snafu-ca/serial-gauge/docs/parts included.png

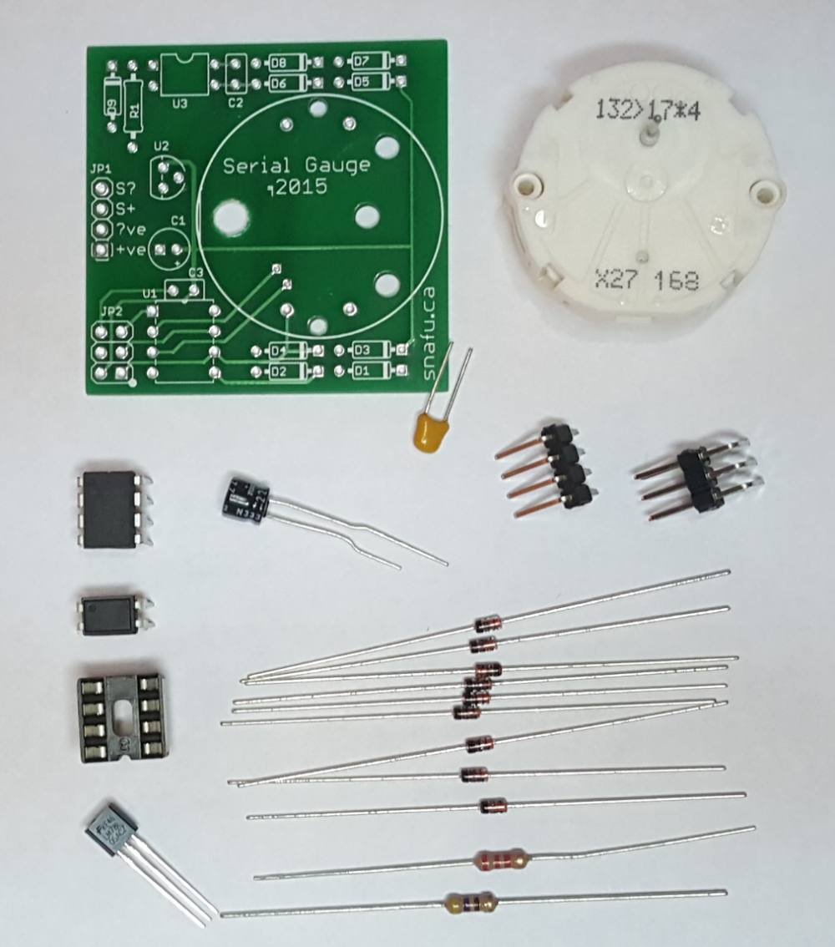
docs/parts included.png
