snafu-ca/serial-gauge/docs/Drive From Pi.png

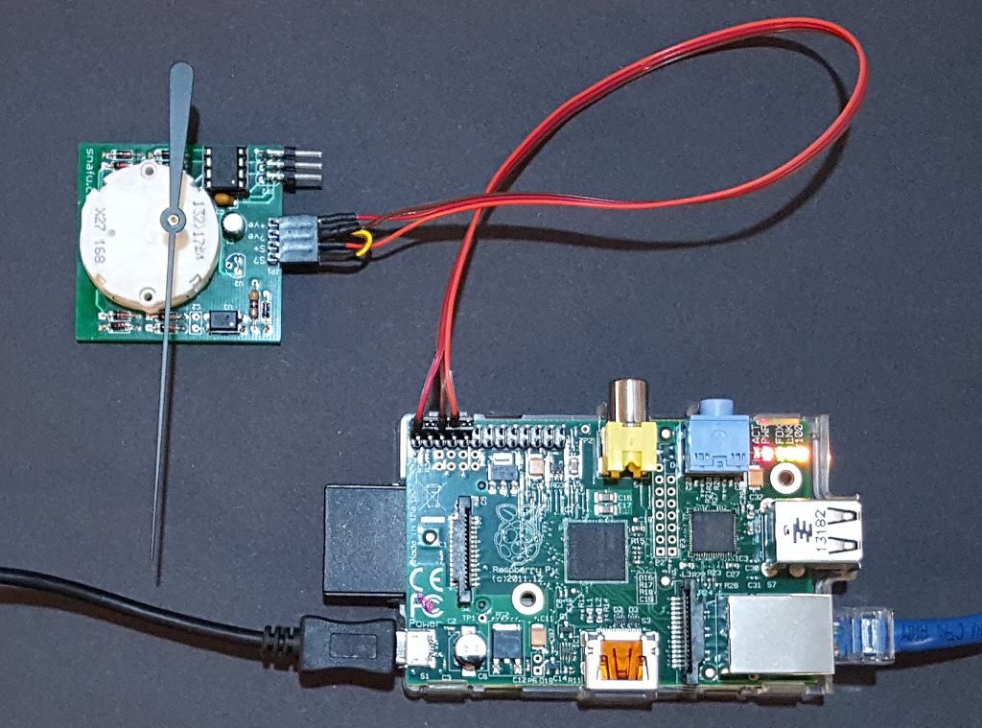
docs/Drive From Pi.png
