snafu-ca/serial-gauge/docs/Drive From USB Serial.png

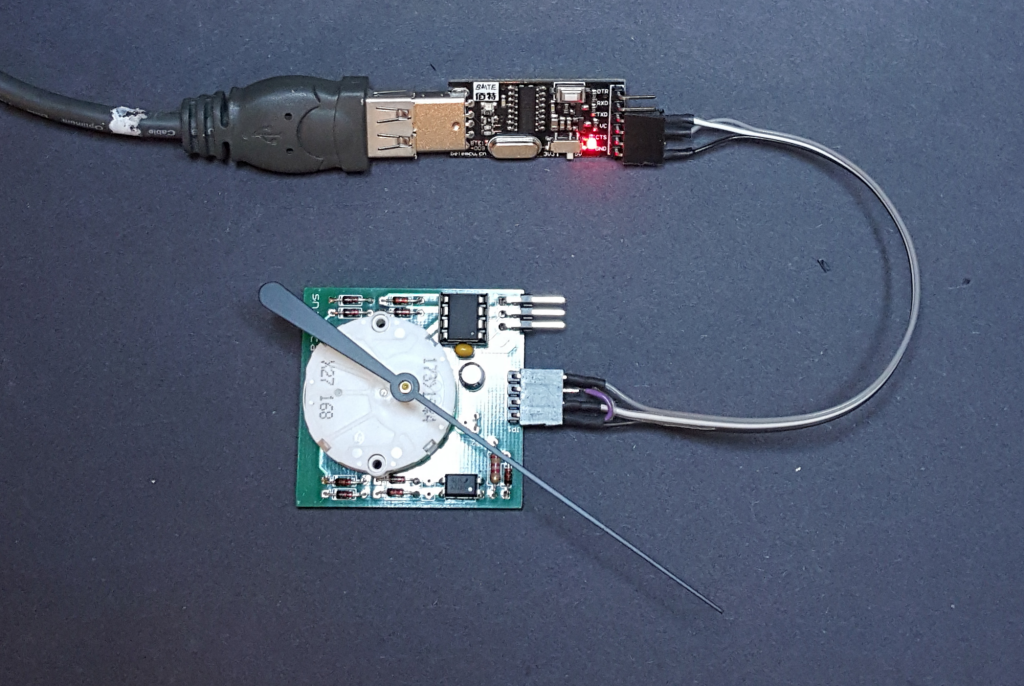
docs/Drive From USB Serial.png
