snafu-ca/serial-gauge/docs/gauge.png

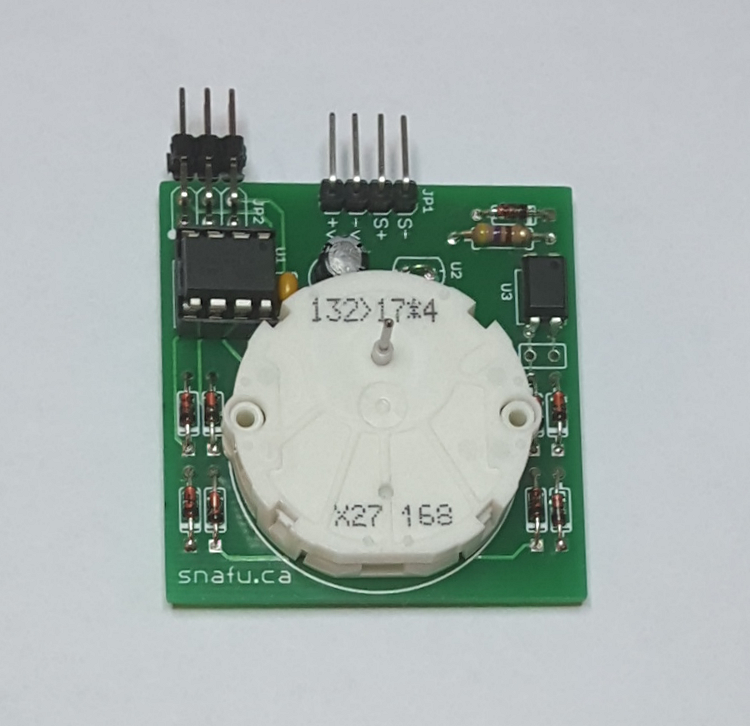
docs/gauge.png
