snafu-ca/serial-gauge/docs/Hookup To Pi.png

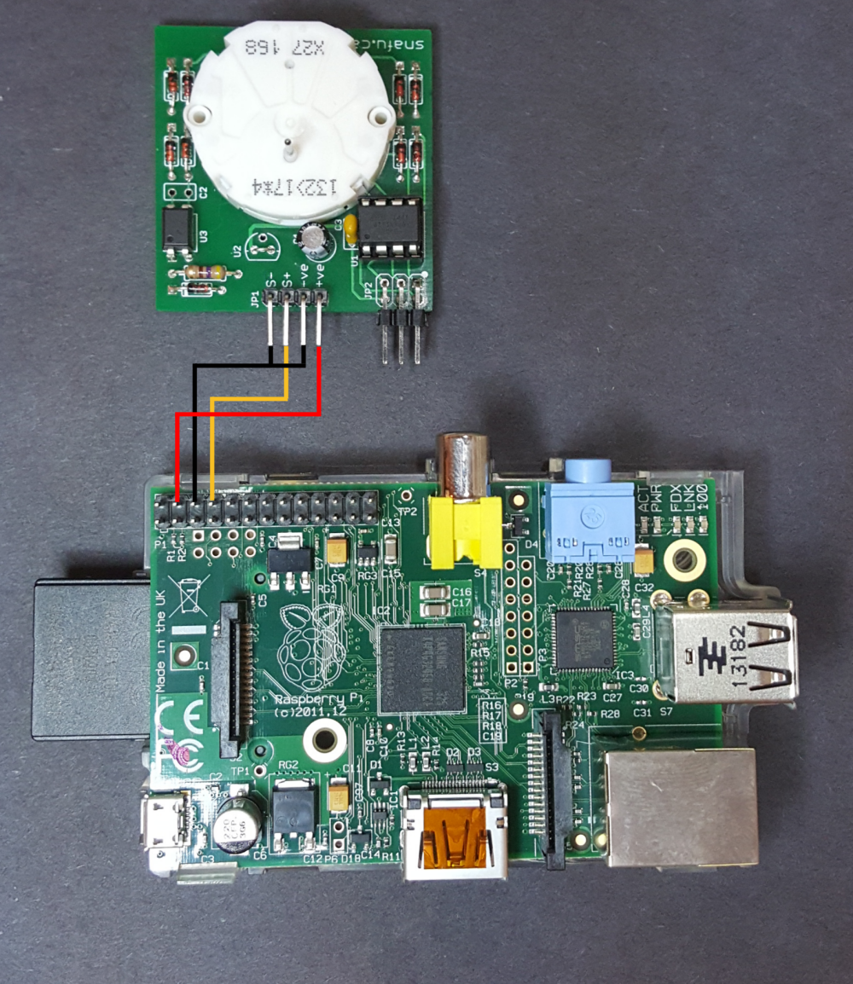
docs/Hookup To Pi.png
