snafu-ca/serial-gauge/docs/Hookup To USB Serial.png

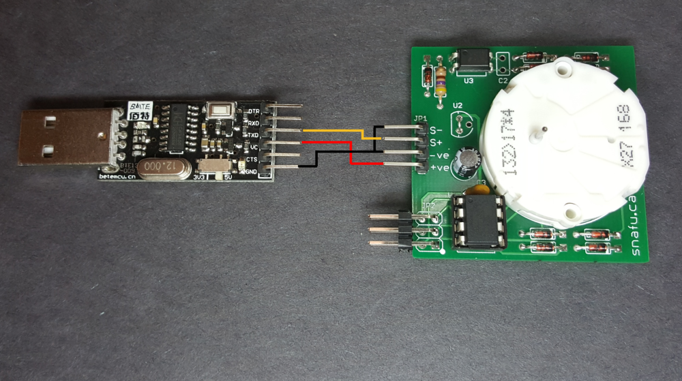
docs/Hookup To USB Serial.png
