snafu-ca/serial-gauge/docs/pcb.png

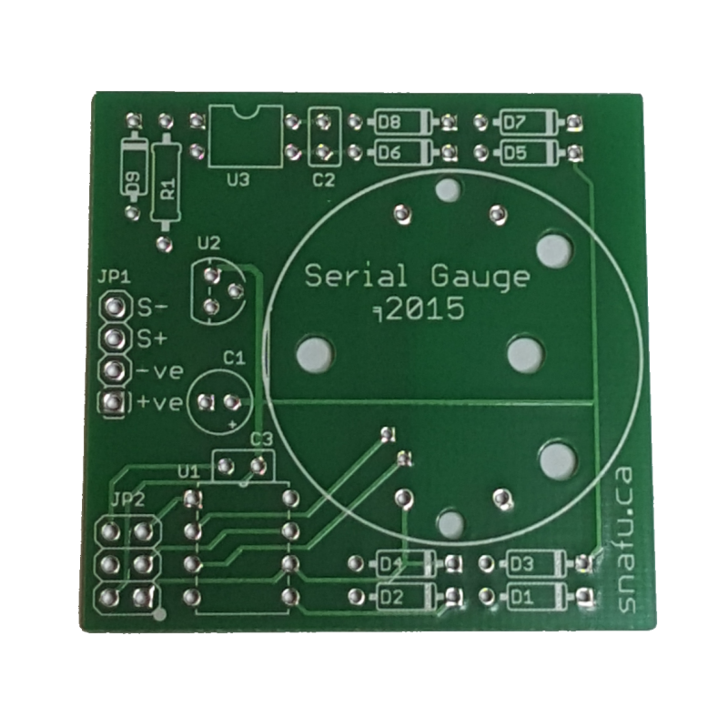
docs/pcb.png
