snafu-ca/serial-gauge/docs/parts layout.png

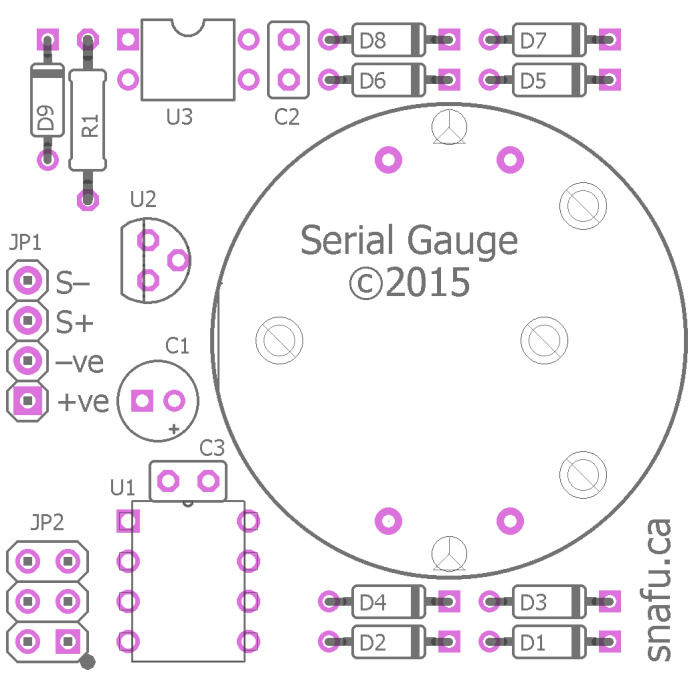
docs/parts layout.png
