snafu-ca/serial-gauge/docs/Schematic.pdf

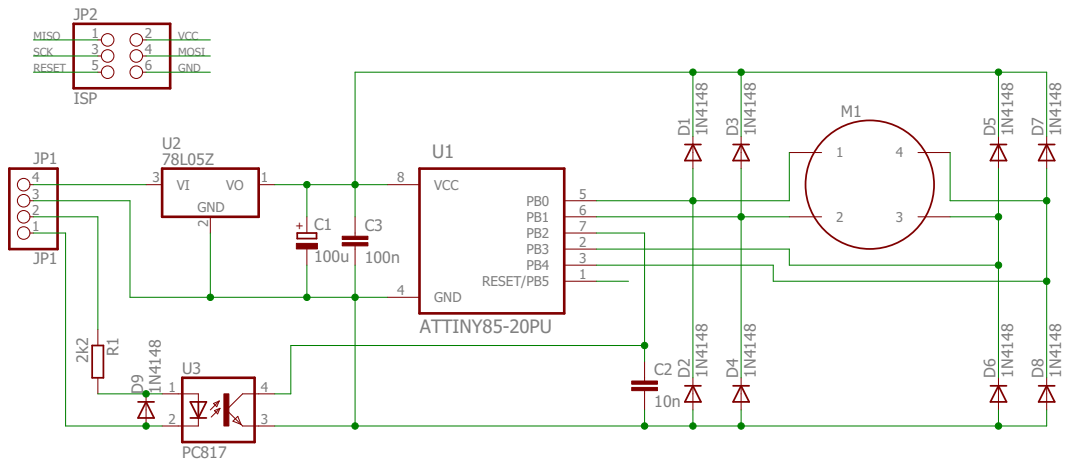
[picture p9: page 1]

Reference: http://snafu.ca/category/serial-gauge/ | Rev: C

Date: 07/08/2016 3:29 PM | Sheet: 1/1
